NortheastDesigns/Chimera-MK7/Chimera MK7 HW Kit Package Contents.pdf

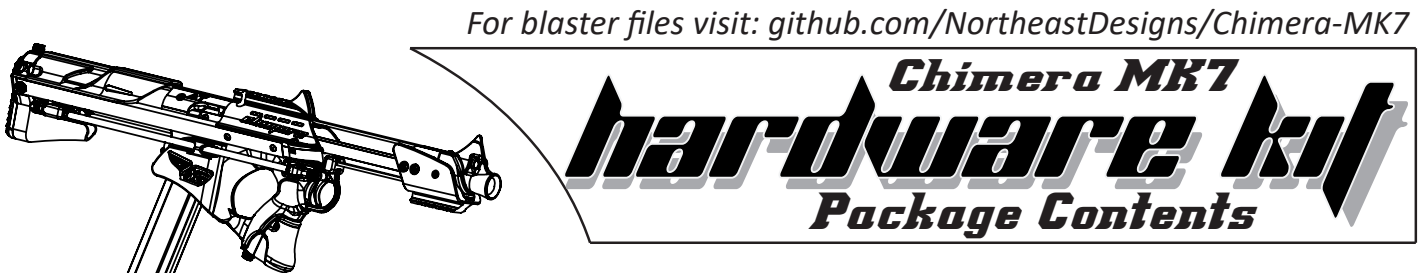
[picture p1: figure]
Chimera MK7; Package Contents; For blaster files visit: github.com/NortheastDesigns/Chimera-MK7 hardware kit Hardware kit

This work is licensed under the Creative Commons Attribution-NonCommercial 4.0 International License. To view a copy of this license, visit http://creativecommons.org/licenses/by-nc/4.0/

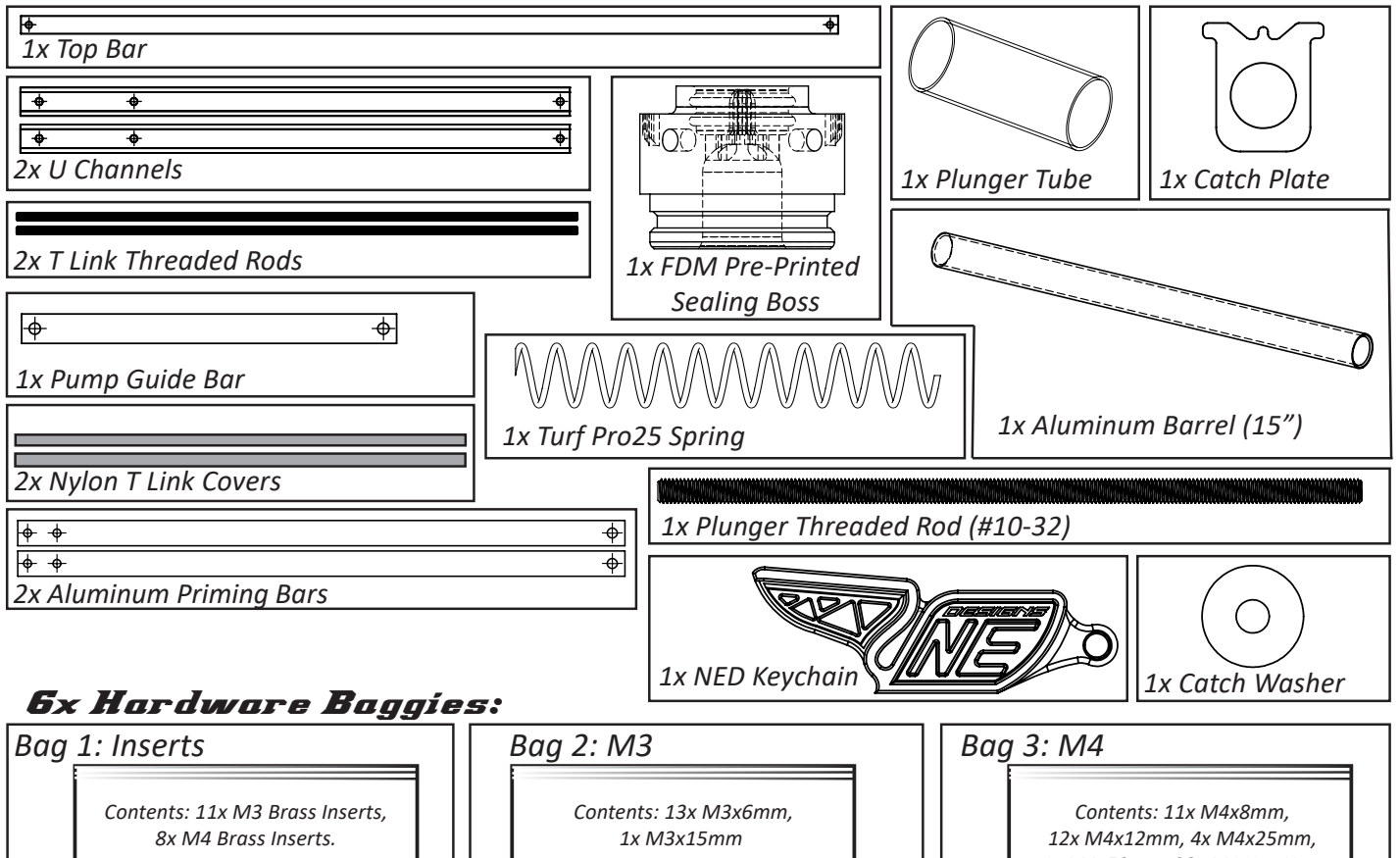
[picture p2: figure]
6x Hardware Baggies:; Lorem ipsum; 1x Aluminum Barrel (15”); 1x Plunger Tube; 1x Catch Plate; 1x FDM Pre-Printed Sealing Boss; 1x Turf Pro25 Spring; 1x Plunger Threaded Rod (#10-32); 2x U Channels; 1x Pump Guide Bar; Bag 1: Inserts; Bag 2: M3; Bag 3: M4; 2x Nylon T Link Covers; 2x Aluminum Priming Bars; 1x Top Bar; 2x T Link Threaded Rods; Contents: 13x M3x6mm, 1x M3x15mm; Contents: 11x M4x8mm, 12x M4x12mm, 4x M4x25mm,; Contents: 11x M3 Brass Inserts, 8x M4 Brass Inserts.; 1x NED Keychain; 1x Catch Washer

## Scan this QR Code for Blaster Files!

Bag 4: O Rings | Bag 5: Other

1x M4x50mm, 28x M4 Hex Nuts, 1x M4 Nylock Nut

Contents: 1x 123 Buna X ring,
1x 123 Buna O ring, 3x 202 Buna O rings.

Contents: 3x Small Compression Springs, 1x Small Extension Spring, 1x T Link pin, 2x 10-32 Acorn Nuts. 1x 2.0mm Hex Key, 1x 2.5mm Hex Key

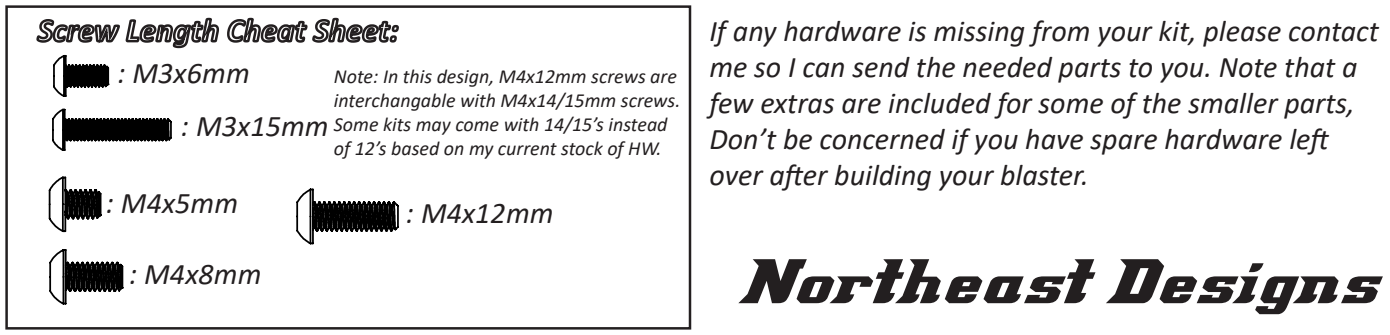
[picture p3: figure]
Northeast Designs; interchangable with M4x14/15mm screws. Some kits may come with 14/15’s instead; over after building your blaster.

Note: In this design, M4x12mm screws are

of 12’s based on my current stock of HW.

If any hardware is missing from your kit, please contact me so I can send the needed parts to you. Note that a few extras are included for some of the smaller parts, Don’t be concerned if you have spare hardware left
