NortheastDesigns/Chimera-MK7/Group A/Mag Release AT.STL

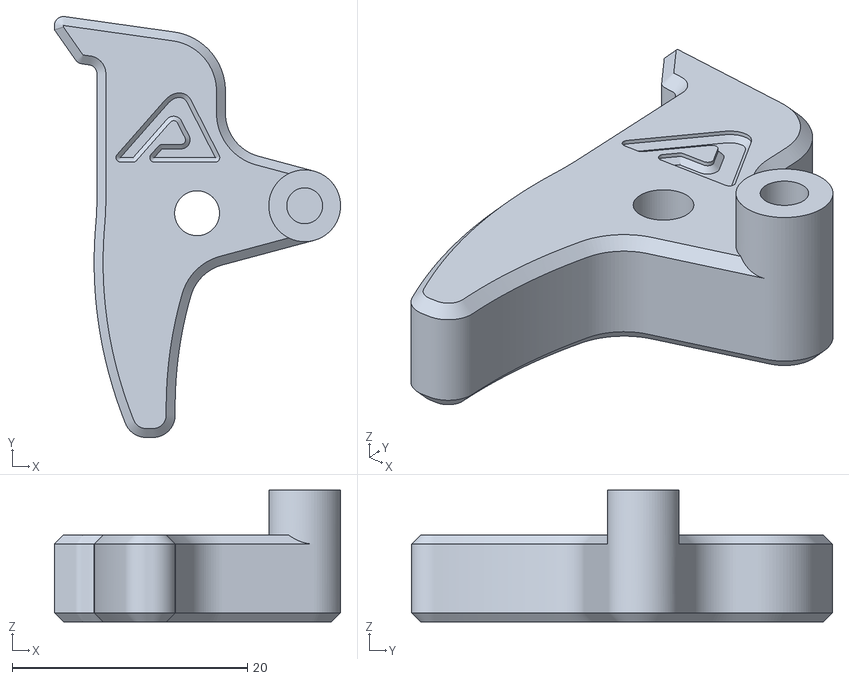
[picture p4: CAD file, 2021-09-02]
Group A/Mag Release AT.STL
24.3 x 35.8 x 11.2
