NortheastDesigns/Chimera-MK7/Group B/K18 Plunger.STL

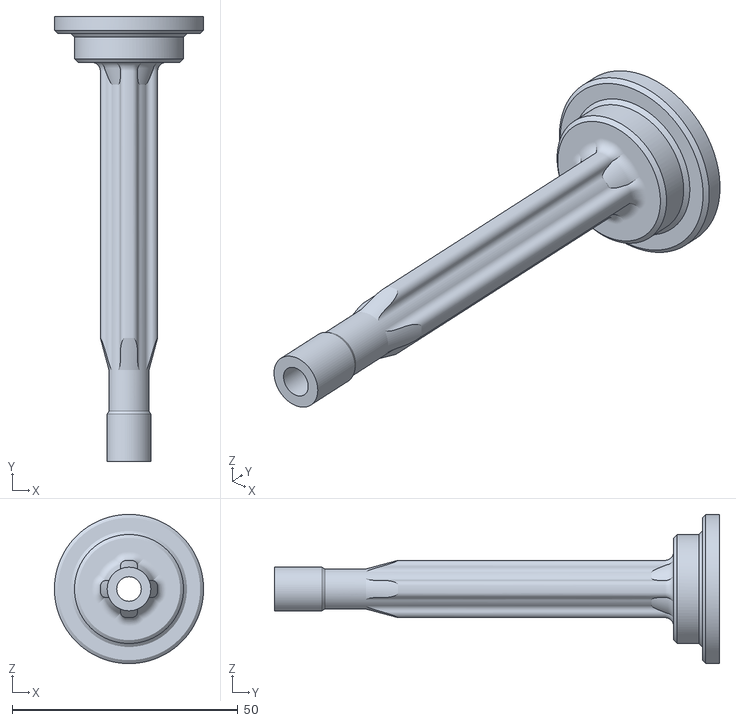
[picture p5: CAD file, 2021-09-02]
Group B/K18 Plunger.STL
33.0 x 98.5 x 33.0
