NortheastDesigns/Chimera-MK7/Group D/SNOWO Plate.STL

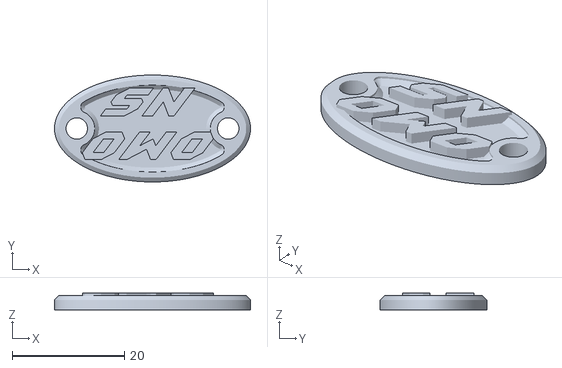
[picture p7: CAD file, 2021-08-14]
Group D/SNOWO Plate.STL
34.9 x 19.0 x 3.01
