NortheastDesigns/Chimera-MK7/Group E/Grip Panel.STL

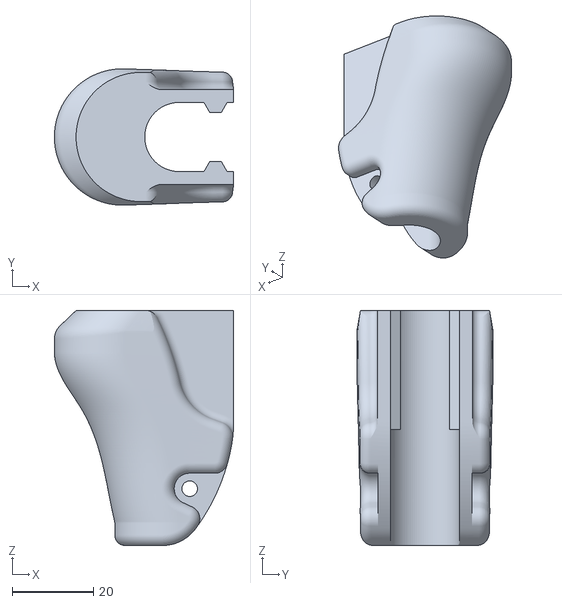
[picture p8: CAD file, 2021-08-14]
Group E/Grip Panel.STL
44.1 x 33.5 x 57.8
