NortheastDesigns/Chimera-MK7/Spring Spacers/K18 Spacer Max.STL

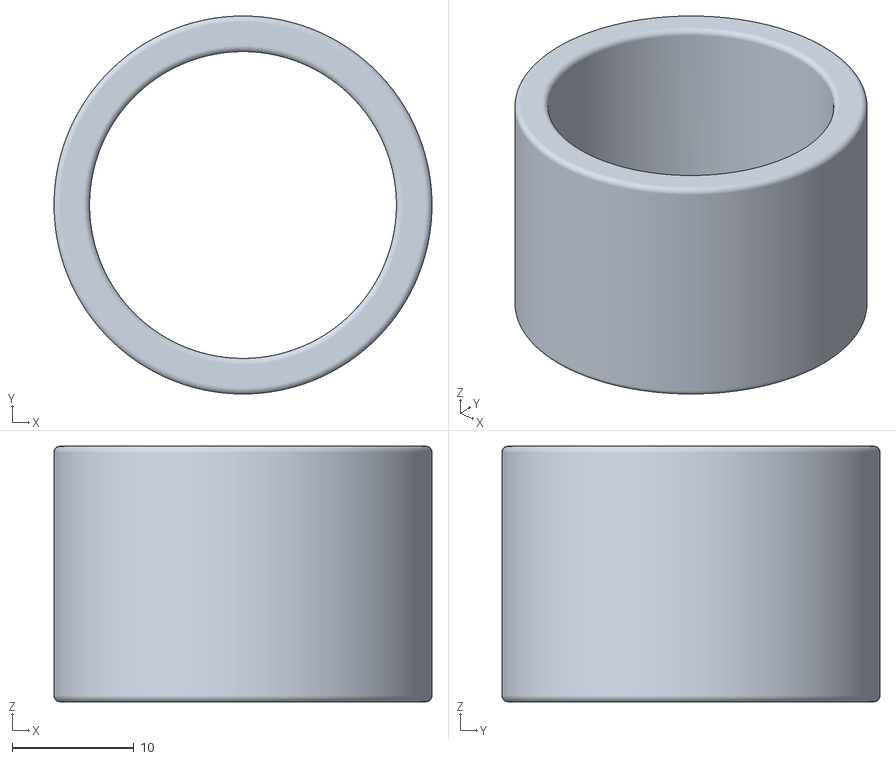
[picture p9: CAD file, 2021-09-02]
Spring Spacers/K18 Spacer Max.STL
31.0 x 31.0 x 21.0
