NortheastDesigns/Chimera-MK7/Group A/Receiver AT.STL

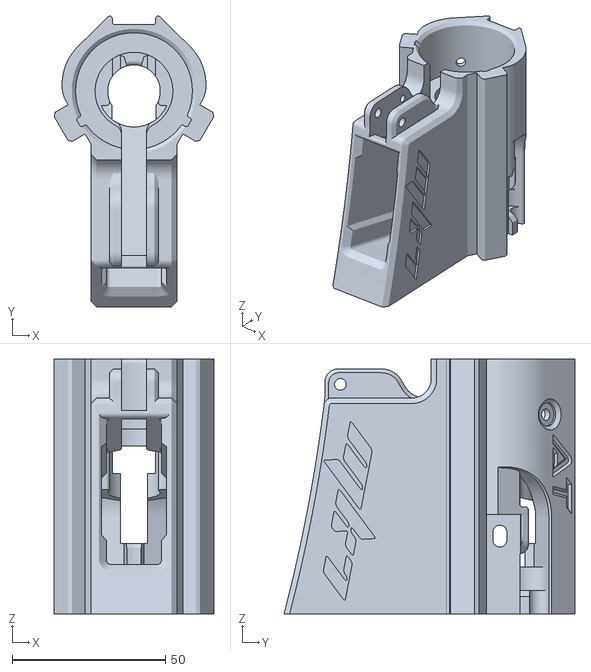
[picture p10: CAD file, 2021-09-02]
Group A/Receiver AT.STL
52.2 x 95.0 x 83.2
