NortheastDesigns/Chimera-MK7/Group B/Actuator.STL

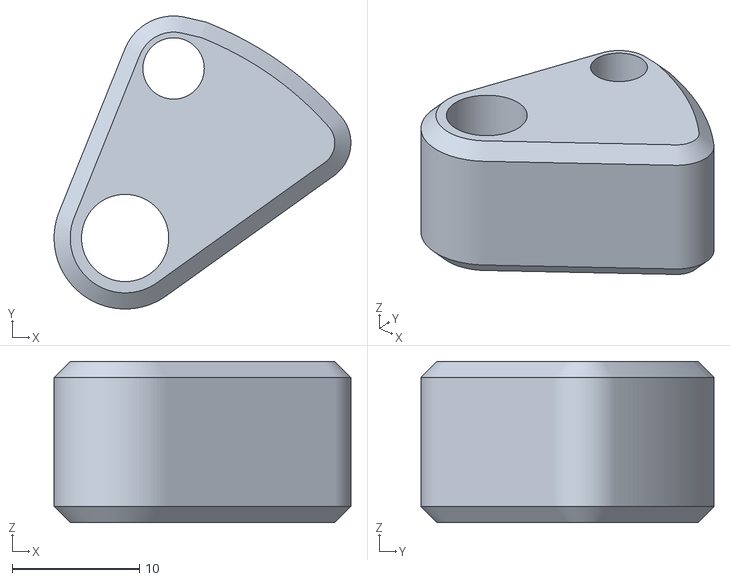
[picture p11: CAD file, 2021-08-14]
Group B/Actuator.STL
23.3 x 23.0 x 12.7
