NortheastDesigns/Chimera-MK7/Group C/K25 Cheek Gaurd.STL

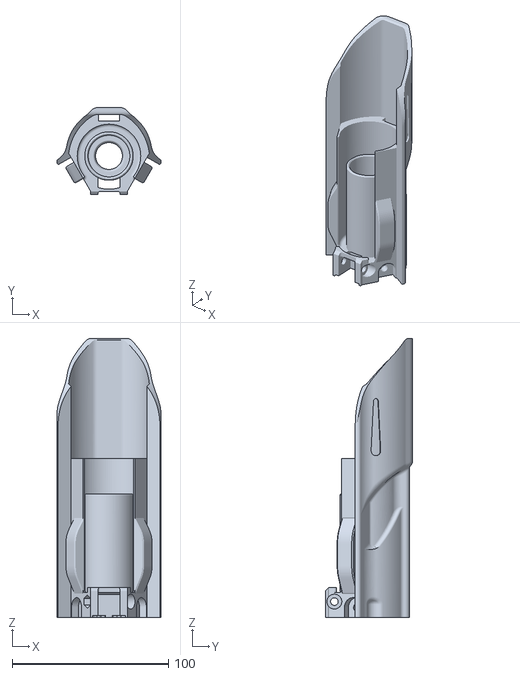
[picture p12: CAD file, 2021-09-02]
Group C/K25 Cheek Gaurd.STL
66.8 x 55.7 x 178.4
