NortheastDesigns/Chimera-MK7/Group D/Feed Ramp.STL

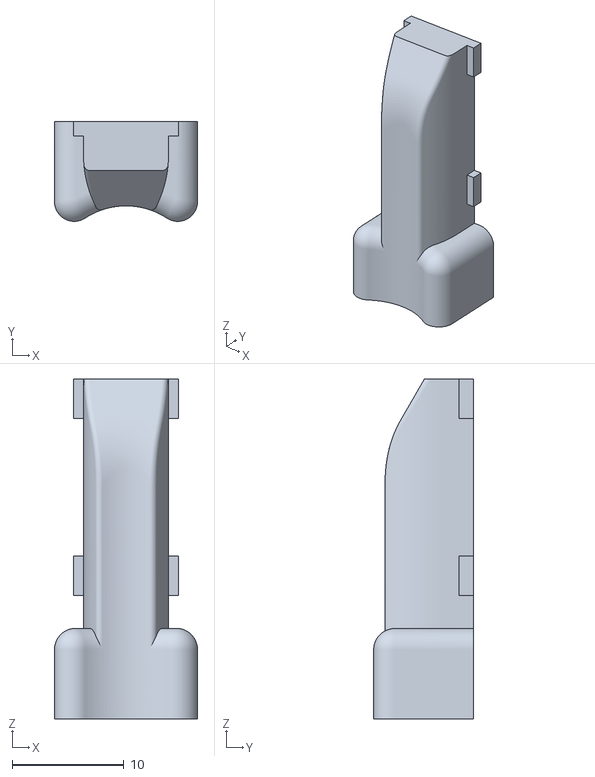
[picture p13: CAD file, 2021-08-14]
Group D/Feed Ramp.STL
12.8 x 8.94 x 30.5
