NortheastDesigns/Chimera-MK7/Spring Spacers/K18 Spacer Mid.STL

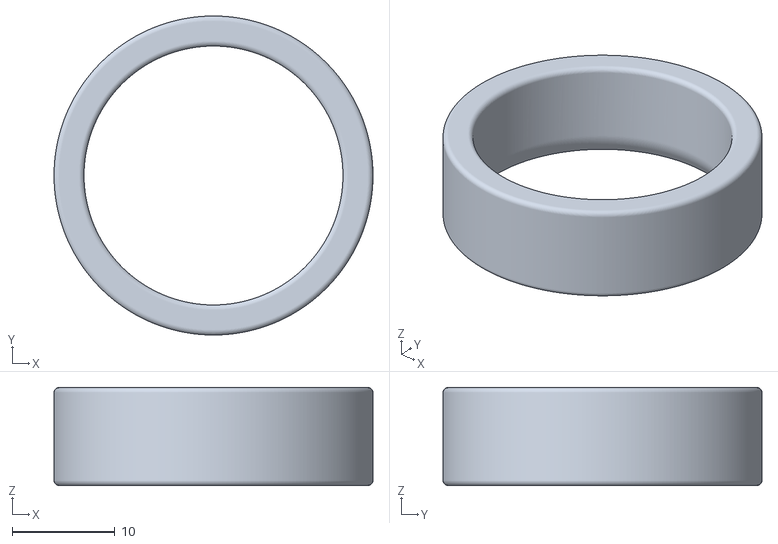
[picture p14: CAD file, 2021-09-02]
Spring Spacers/K18 Spacer Mid.STL
31.0 x 31.0 x 9.53
