NortheastDesigns/Chimera-MK7/Group A/Mag Release ST.STL

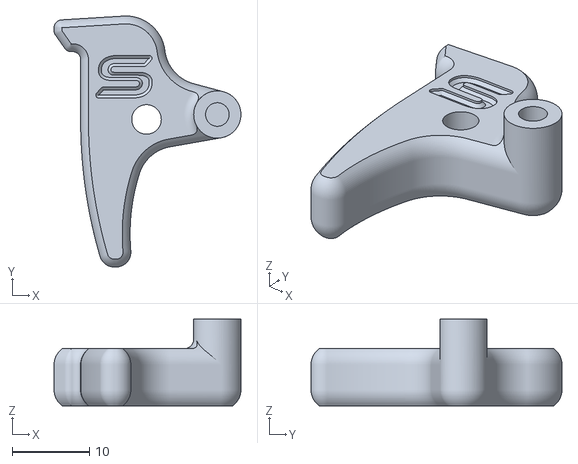
[picture p15: CAD file, 2021-09-02]
Group A/Mag Release ST.STL
24.1 x 32.4 x 11.2
