NortheastDesigns/Chimera-MK7/Group B/Tlink Knuckle Front.STL

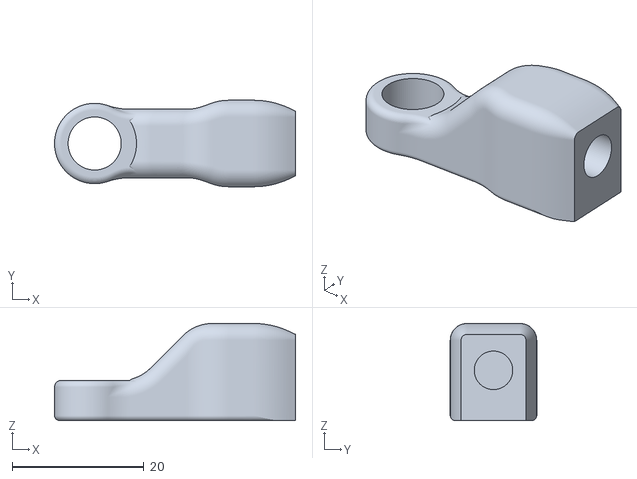
[picture p16: CAD file, 2021-08-14]
Group B/Tlink Knuckle Front.STL
36.6 x 13.1 x 14.7
