NortheastDesigns/Chimera-MK7/Group C/Pump.STL

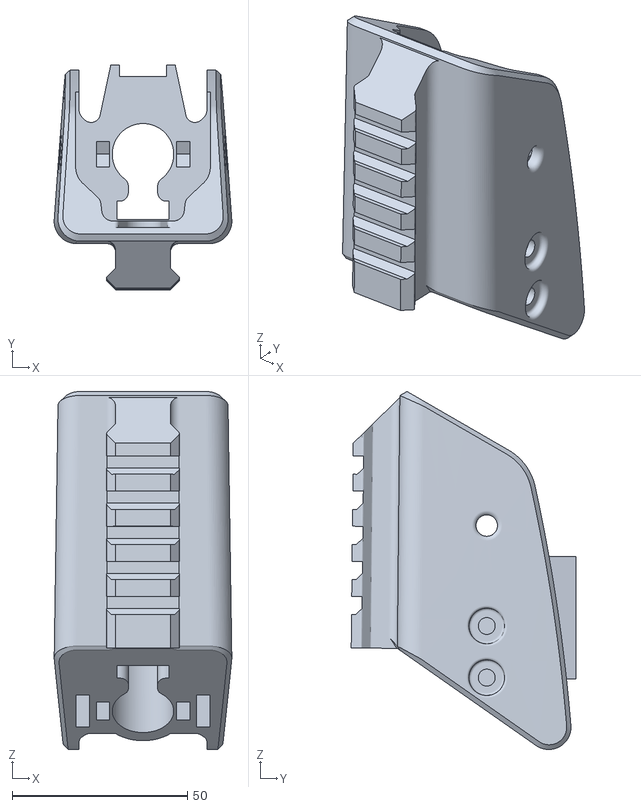
[picture p17: CAD file, 2021-08-14]
Group C/Pump.STL
50.7 x 64.1 x 102.1
