NortheastDesigns/Chimera-MK7/Spring Spacers/K25 Spacer Max.STL

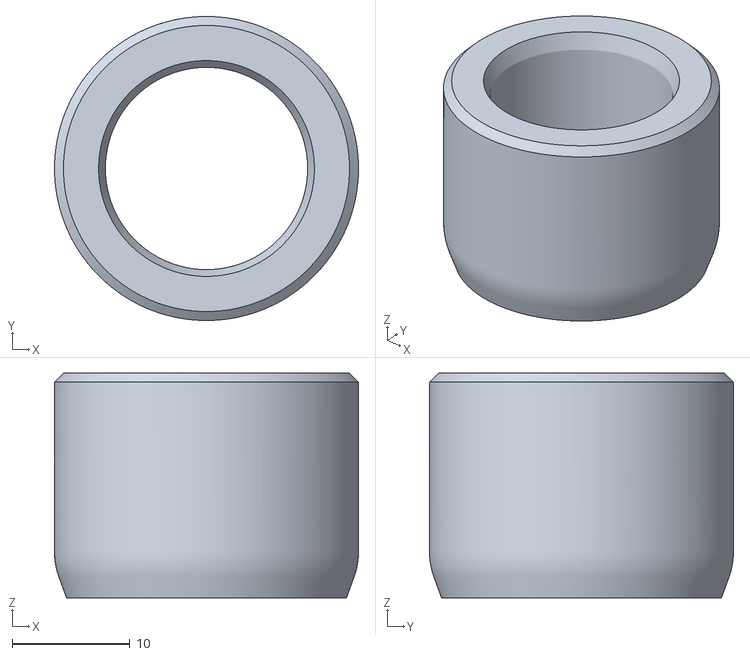
[picture p18: CAD file, 2021-09-02]
Spring Spacers/K25 Spacer Max.STL
25.8 x 25.8 x 19.1
