NortheastDesigns/Chimera-MK7/Group A/Receiver ST.STL

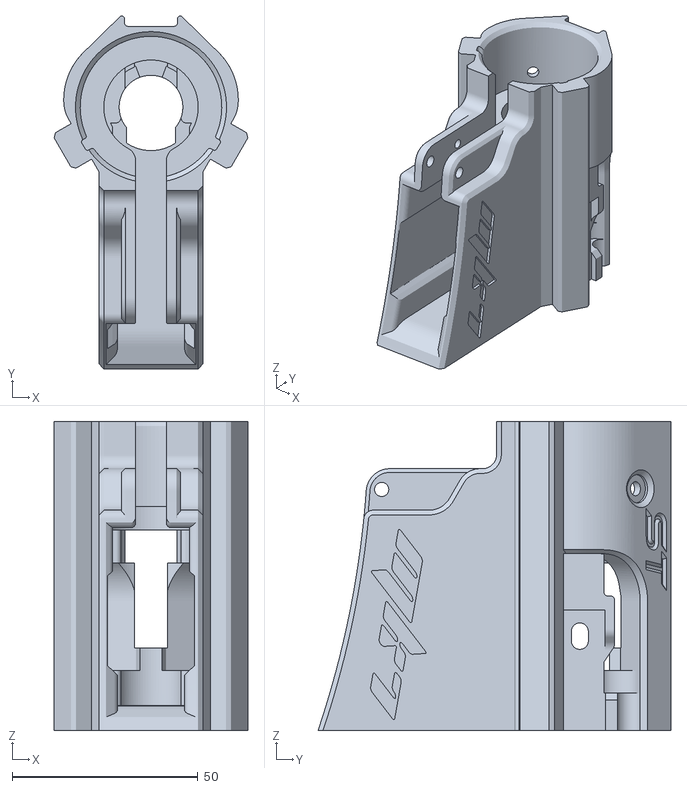
[picture p19: CAD file, 2021-09-02]
Group A/Receiver ST.STL
52.2 x 95.0 x 83.2
