NortheastDesigns/Chimera-MK7/Group B/Catch Surface.STL

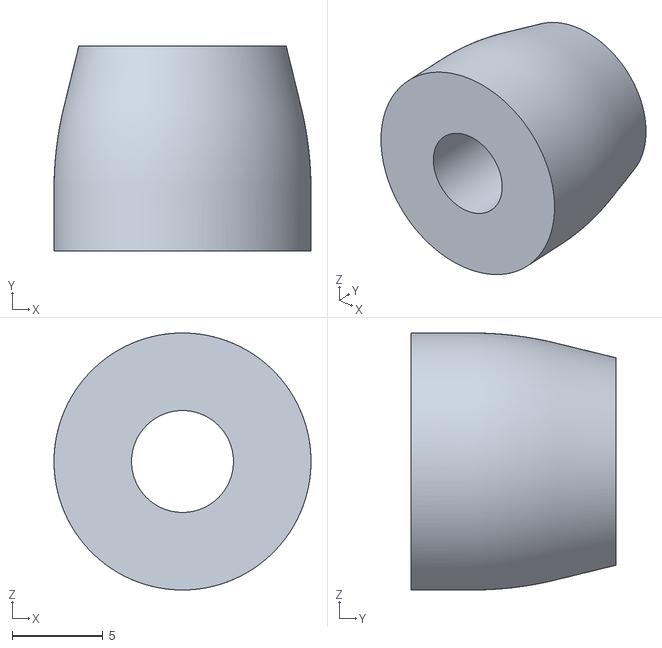
[picture p20: CAD file, 2021-08-14]
Group B/Catch Surface.STL
14.2 x 11.3 x 14.2
