NortheastDesigns/Chimera-MK7/Spring Spacers/K25 Spacer Mid.STL

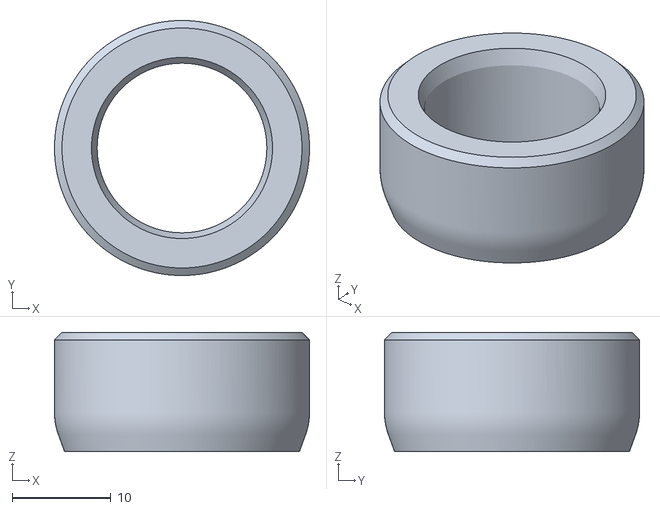
[picture p21: CAD file, 2021-09-02]
Spring Spacers/K25 Spacer Mid.STL
25.8 x 25.8 x 12.1
