NortheastDesigns/Chimera-MK7/Group A/Magwell Shroud.STL

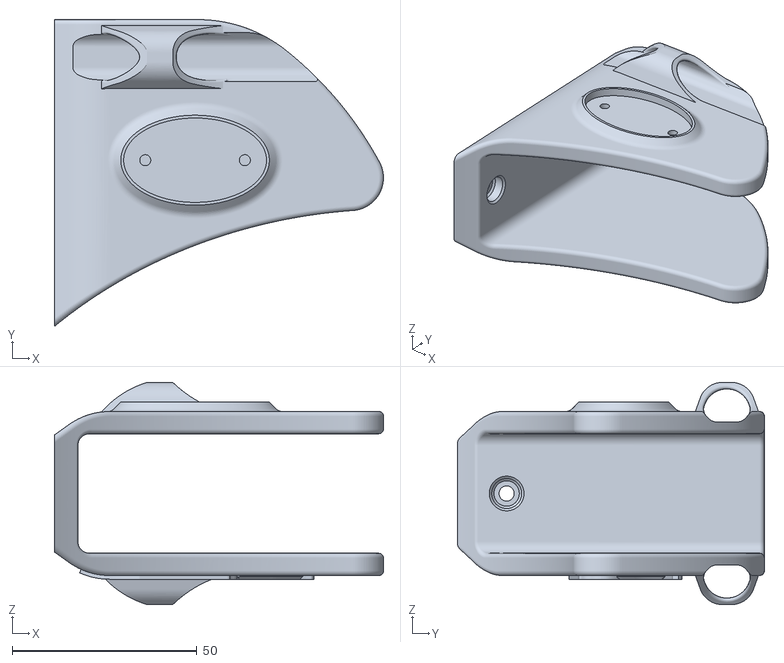
[picture p22: CAD file, 2021-08-14]
Group A/Magwell Shroud.STL
89.2 x 83.1 x 60.2
