NortheastDesigns/Chimera-MK7/Group B/Trigger.STL

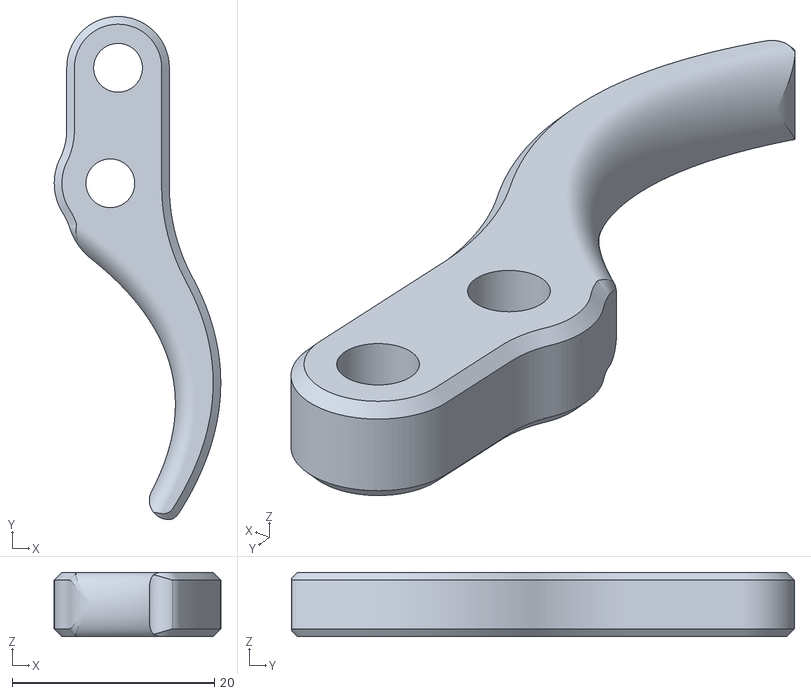
[picture p23: CAD file, 2021-08-14]
Group B/Trigger.STL
16.5 x 49.8 x 6.35
