NortheastDesigns/Chimera-MK7/Group D/Feed Cover.STL

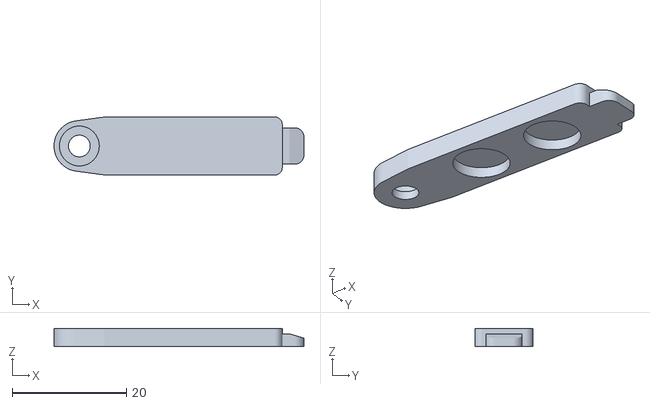
[picture p24: CAD file, 2021-08-14]
Group D/Feed Cover.STL
43.8 x 10.2 x 3.17
