NortheastDesigns/Chimera-MK7/Group A/Stock.STL

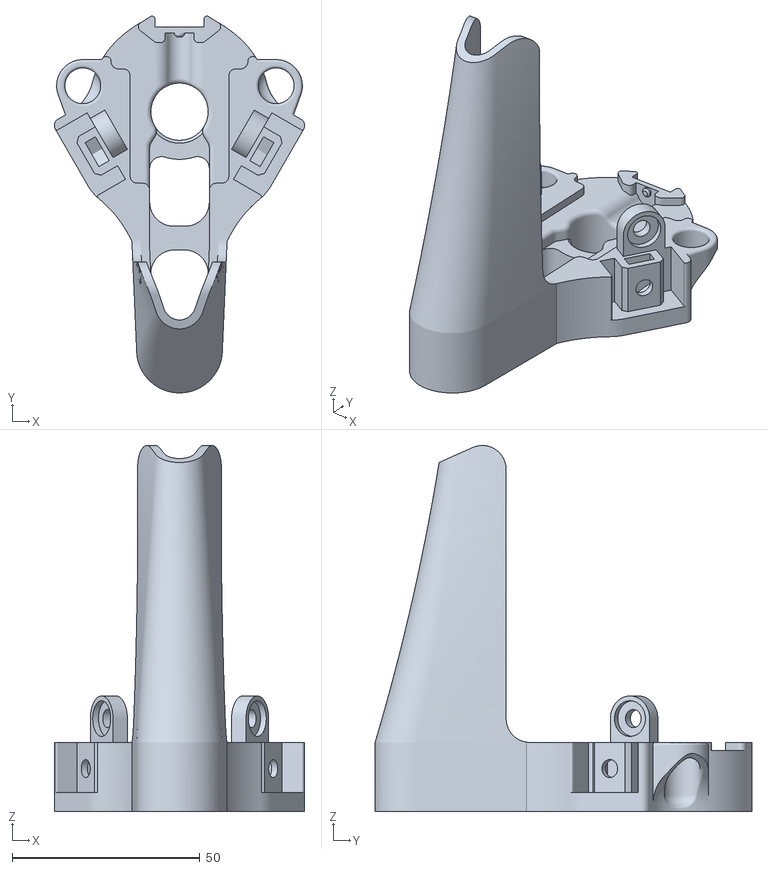
[picture p25: CAD file, 2021-08-14]
Group A/Stock.STL
66.8 x 100.4 x 97.5
