NortheastDesigns/Chimera-MK7/Group B/Tlink Knuckle Rear.STL

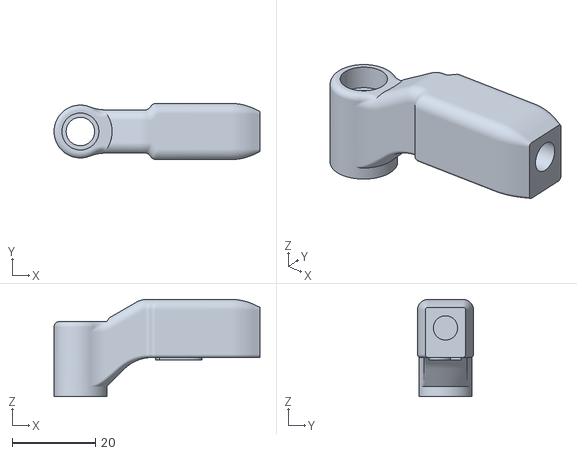
[picture p26: CAD file, 2021-08-14]
Group B/Tlink Knuckle Rear.STL
49.5 x 13.5 x 23.4
