NortheastDesigns/Chimera-MK7/Group A/Front Rail.STL

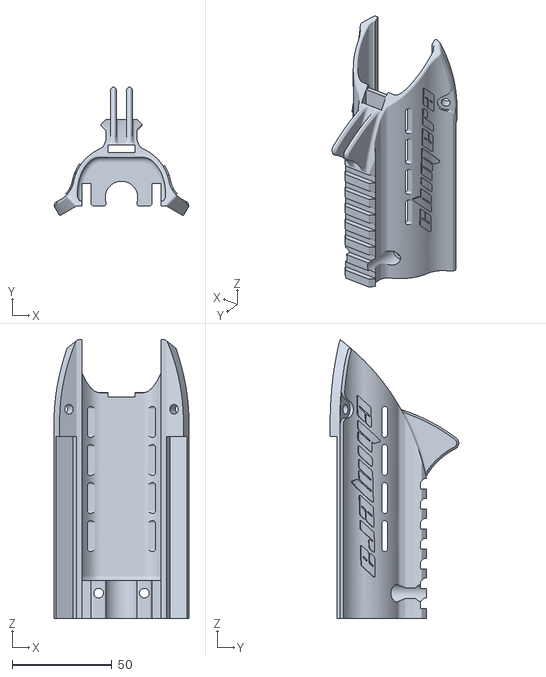
[picture p27: CAD file, 2021-08-14]
Group A/Front Rail.STL
67.6 x 64.4 x 139.7
