NortheastDesigns/Chimera-MK7/Group B/T Gaurd.STL

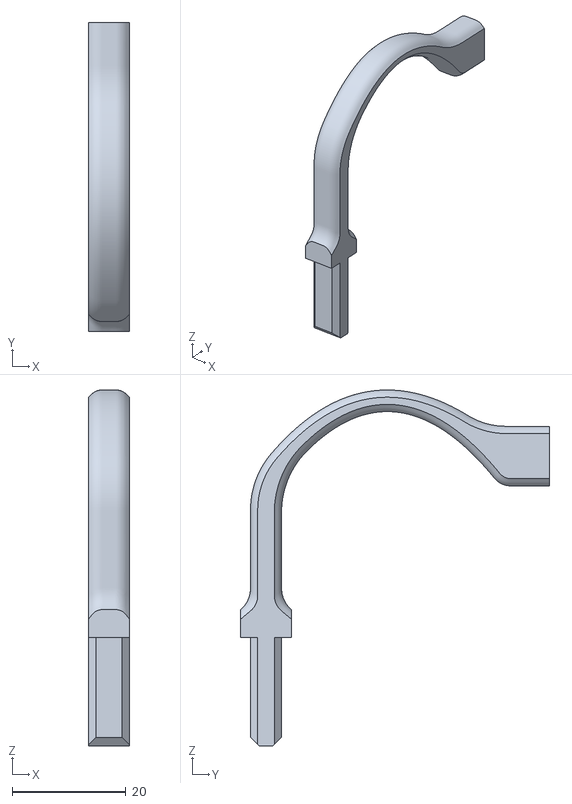
[picture p28: CAD file, 2021-08-14]
Group B/T Gaurd.STL
7.18 x 54.2 x 62.6
