NortheastDesigns/Chimera-MK7/Group B/Tlink Pivot.STL

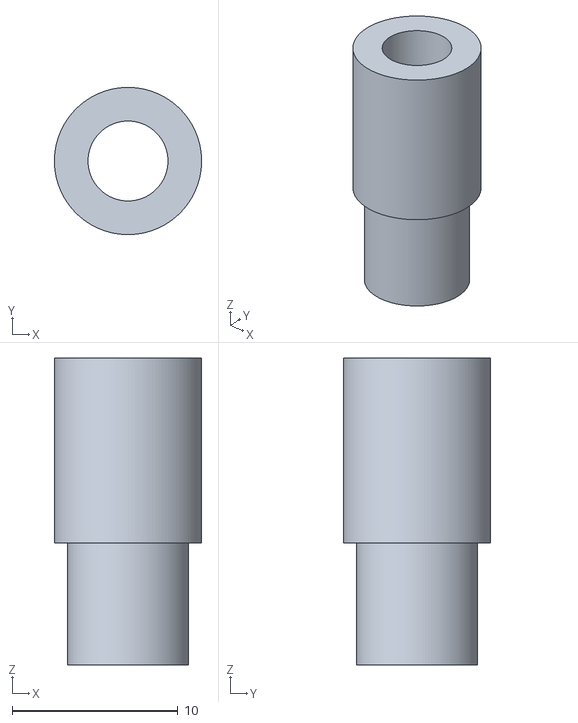
[picture p29: CAD file, 2021-08-14]
Group B/Tlink Pivot.STL
8.89 x 8.89 x 18.5
