NortheastDesigns/Chimera-MK7/Group B/Plunger Top.STL

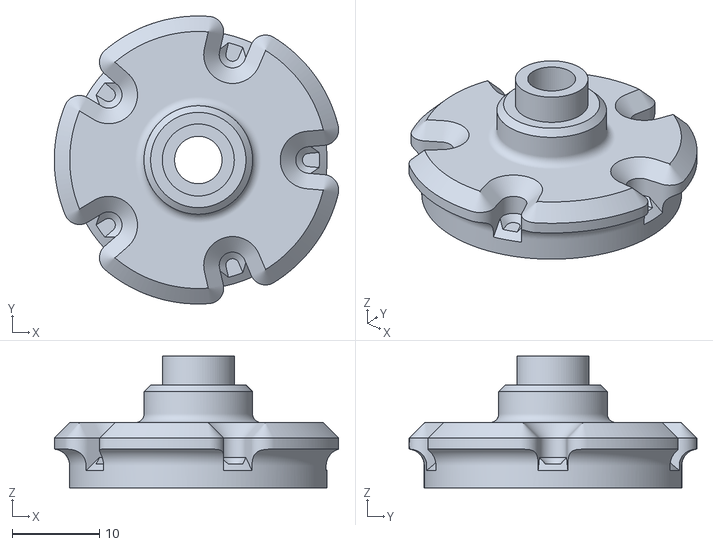
[picture p30: CAD file, 2021-08-14]
Group B/Plunger Top.STL
32.6 x 33.0 x 15.1
