NortheastDesigns/Chimera-MK7/Group B/K25 Plunger.STL

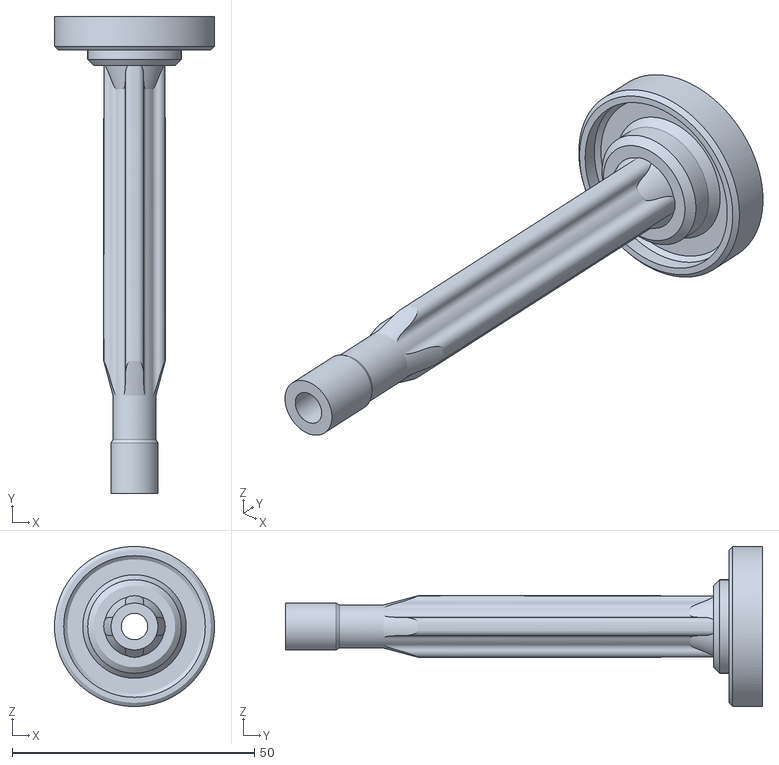
[picture p31: CAD file, 2021-08-14]
Group B/K25 Plunger.STL
33.0 x 98.5 x 33.0
