NortheastDesigns/Chimera-MK7/(list of files, cad)

Other CAD files:
Group D/SNDIY Plate.STL
Group D/SN69 Plate.STL
Group D/M4 Thumbscrew.STL
