NortheastDesigns/Chimera-MK7/Group A/Group A Print Orientations.PNG

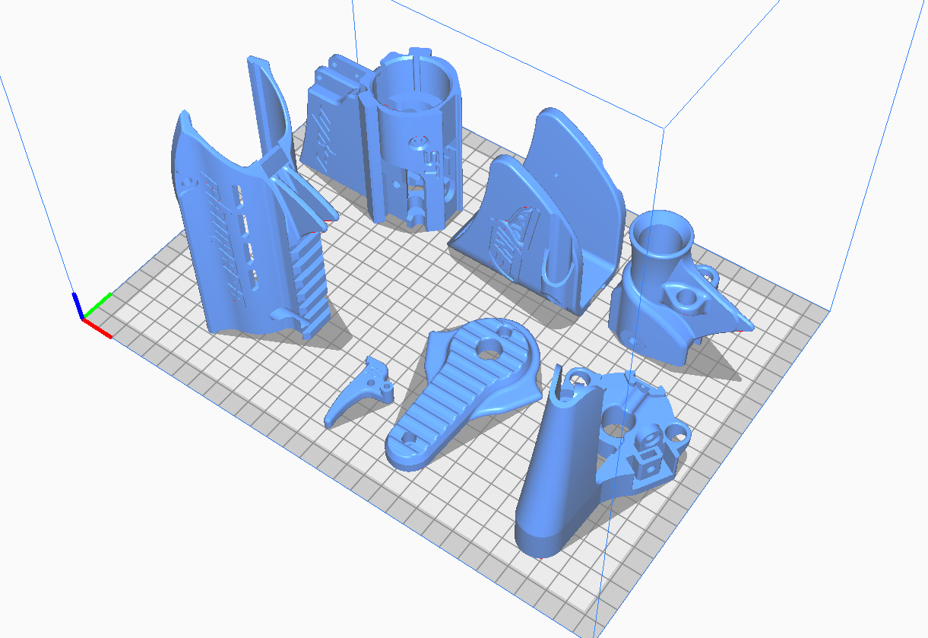
Group A/Group A Print Orientations.PNG
