NortheastDesigns/Chimera-MK7/Group B/Group B Print Orientations.PNG

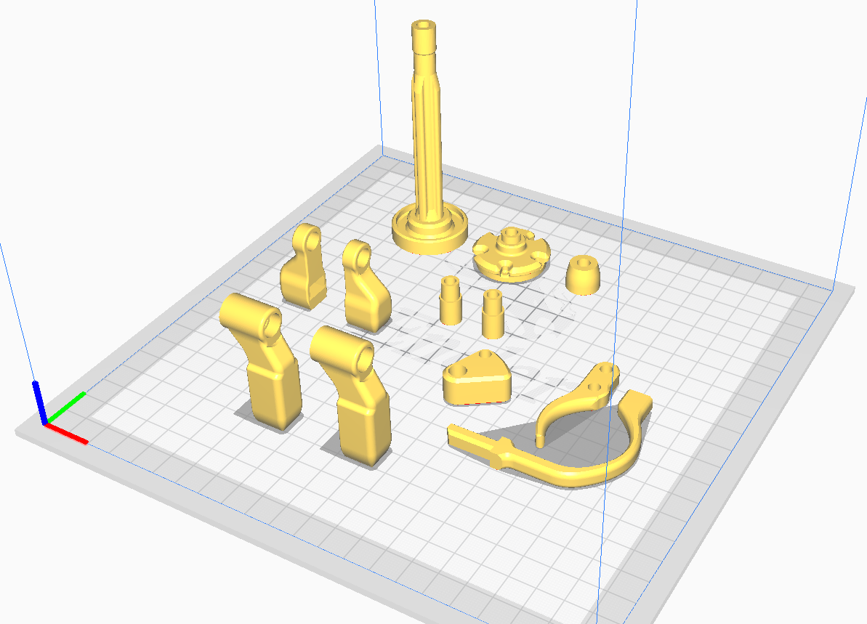
Group B/Group B Print Orientations.PNG
