NortheastDesigns/Chimera-MK7/Group C/Group C Print Orientations.PNG

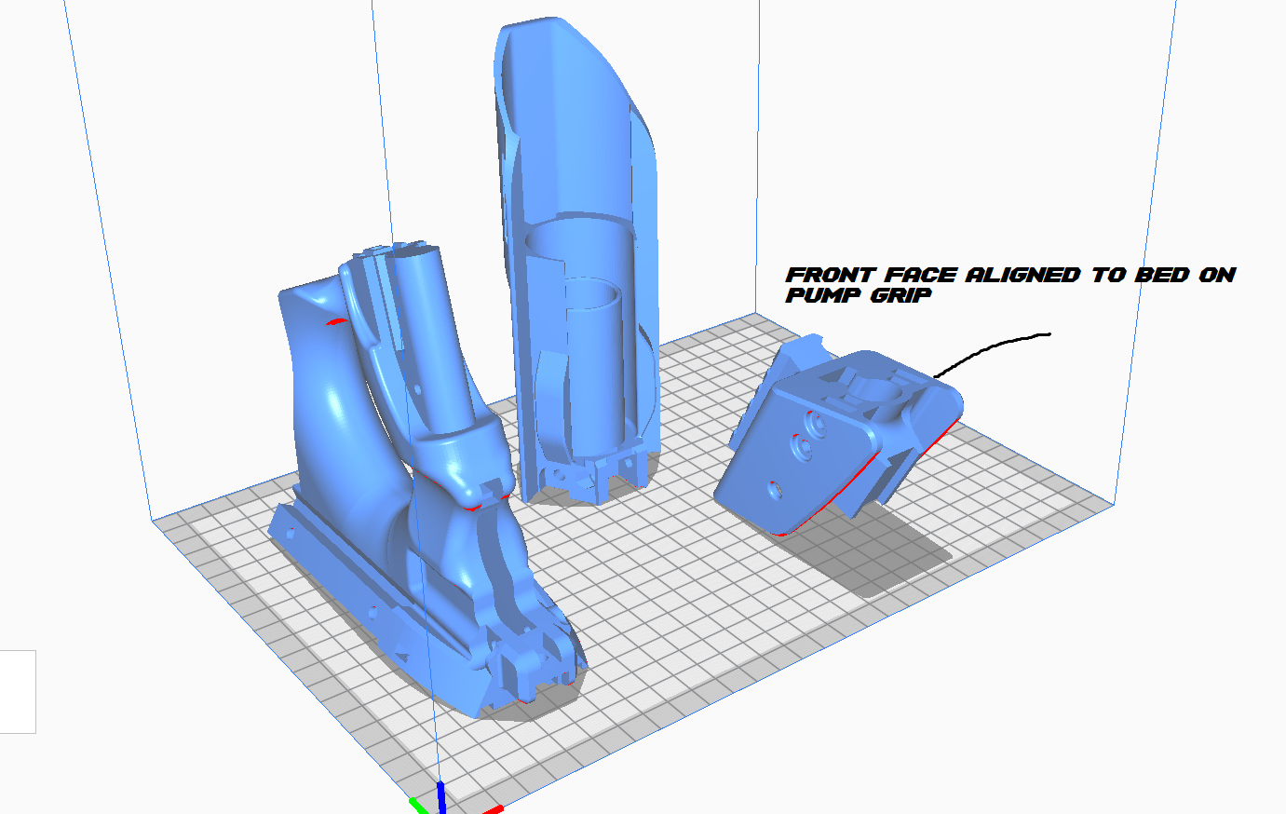
Group C/Group C Print Orientations.PNG
