NortheastDesigns/Chimera-MK7/Group D/Group D Print Orientations.PNG

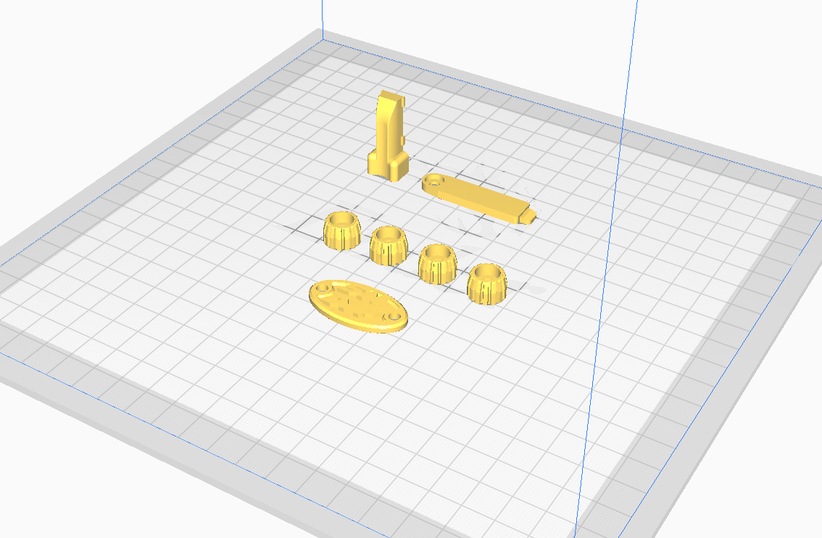
Group D/Group D Print Orientations.PNG
