NortheastDesigns/Chimera-MK7/Group E/Group E Print Orientation.PNG

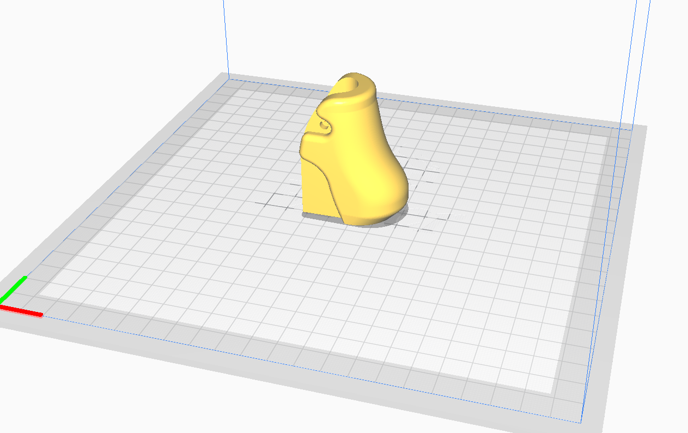
Group E/Group E Print Orientation.PNG
