NortheastDesigns/Chimera-MK7/(threads)

Thread 1 (2023-03-12):

Missing Sealing Boss .STL

Rakoran, 2023-03-12:
Can you add the Sealing Boss .STL file here? I cant buy it since all the hardware kit are sold out and I cant find the file anywhere else.
